Queens-Rocket-Engineering-Team/ctl-panda/README.md

# PANDA Control Board

PANDA (Propulsion Actuation and Nominal Data Acquisition) is the control PCB for the Queen's Rocket Engineering Team's
hybrid rocket engine. During launch, PANDA controls systems on the fill plumbing panel, controls rocket ignition, and
provides pre-launch data acquisition. PANDA also functions as a standalone static fire test stand controller that
can execute all aspects of a hot-fire test.

## Assembled PCB

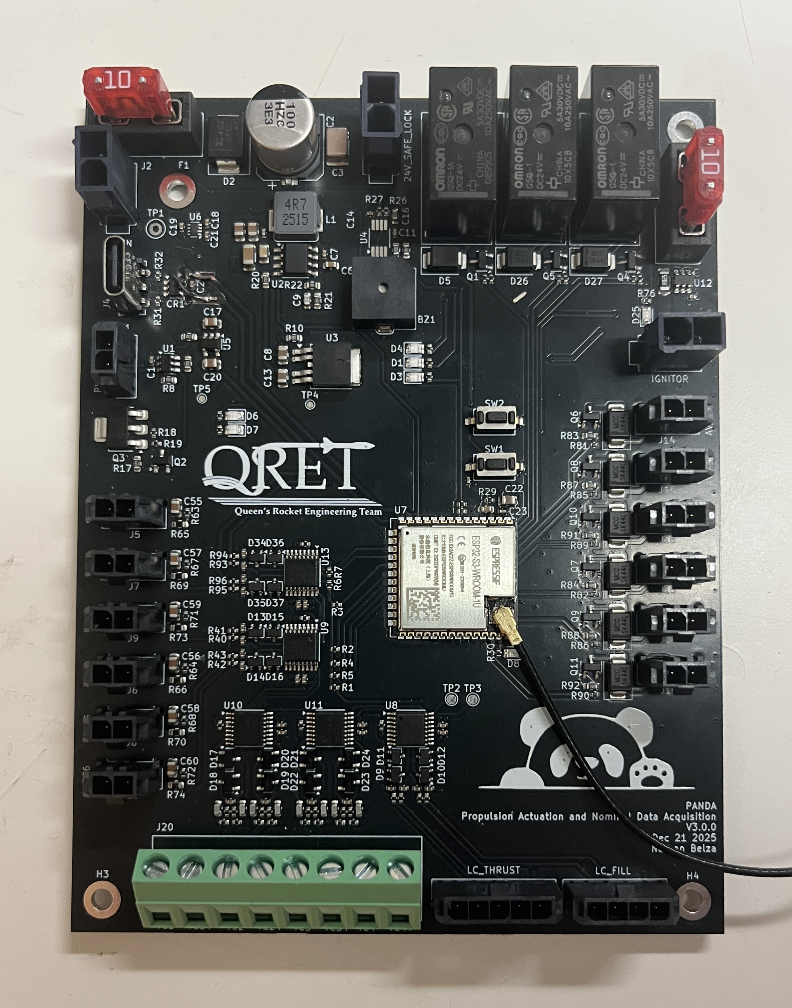
[picture p1: media/assembled_board.jpg]
Assembled PANDA PCB


## System Architecture

PANDA uses an ESP32S3-WROOM-1U microcontroller for systems control. This ESP32S3 communicates with an external control
server to for remote control and data streaming over 2.4GHz WiFi. All commands are sent from the external server, as
PANDA does not autonomously control any systems.

Five ADS112C04 ADCs provide sensor readings to the ESP32S3 over an I2C bus. Sensors supported are:

- 6 pressure transducers
- 4 thermocouples
- 2 load cells

PANDA is also capable of monitoring ignitor characteristics. Measurements of the current passing through a nichrome wire
ignitor are obtained using a current sense amplifier across a shunt resistor in the ignitor path. Ignitor resistance
readings are also measured by injecting a small current from an IDAC on an ADC, and
measuring the resulting voltage.

A communications diagram for PANDA can be seen below.

```mermaid
---
title: PANDA Communications Flow
---
flowchart LR

    ADC(ADS112C04<br>ADCs) <==I2C==> ESP(ESP32 MCU)

    subgraph Controls
        AV(Actuated Valves)
        24VSAFE[24VSAFE<br>Relay]
        RUN[Ignitor Run<br>Relay]
        PRIME[Ignitor Prime<br>Relay]
    end

    subgraph Sensors
        PT(Pressure Transducers)
        TC(Thermocouples)
        LC(Load Cells)
        CUR(Ignitor Current)
        RES(Ignitor Resistance)
    end

    PT --> ADC
    TC --> ADC
    LC --> ADC
    CUR --> ADC
    RES --> ADC

    ESP --> AV
    ESP -->24VSAFE
    ESP --> RUN
    ESP --> PRIME

    ESP <-. WiFI .-> WIFI(External Server)
```

## Power Architecture

PANDA operates from a 24VDC power supply, and has a maximum current rating of 10A. The 24V rail is first stepped down to 5.3V with a switching converter and then dropped to 5V and 3.3V with LDOs. The 5V rail supplies analog systems, and the 3.3V rail supplies digital systems. Using LDOs on the switching output allows for low-noise power for analog measurements.

The 24VSAFE rail is only be energized when the fill panel is vacated, as it powers hazardous components such as the ignitor. The ignitor utilizes two relays in series for additional redundancy, and to ensure ignition is always intentional. A power distribution chart of PANDA can be seen below. This graph does not include the power sequencing and filtering present on the board.

```mermaid
---
title: PANDA Power Distribution
---
flowchart LR

    24VIN([24VIN]) --> 24VSAFE[24VSAFE<br>Relay]

    subgraph Valves
        AV(Valves)
        AVSAFE(Fill Valve<br>Run Valve)
    end
    24VIN --> AV
    24VSAFE --> AVSAFE

    subgraph Ignitor
        RUN[Ignitor Run<br>Relay]
        RUN --> PRIME[Ignitor Prime<br>Relay]
        PRIME --> IGN(Ignitor)
    end

    24VSAFE --> RUN[Ignitor Run<br>Relay]

    subgraph Voltage Regulation
        BUCK([5.3V Buck])
        BUCK --> 5V([5V LDO])
        BUCK --> 3V3([3.3V LDO])
    end

    24VIN --> BUCK([5.3V Buck])

    subgraph Sensors
        PT(Pressure Transducers)
        LC(Load Cells)
        RES(Ignitor Current<br>Sensor)
    end

    5V --> ADC(ADS112C04<br>ADCs)
    3V3 --> ESP(ESP32 MCU)
    3V3 --> ADC
    24VIN --> PT
    5V --> LC
    5V --> RES
```

## Required Software

This project was created using KiCad v10.0. If manufacturing with JLCPCB, install the Fabrication Toolkit KiCad plugin for JLCPCB.

## Recommended Manufacturing Options

If ordering from JLCPCB, use the JLC04161H-3313 stackup option. For JLC PCBA, the standard PCBA option is required due
to the ESP32S3-WROOM-1U being unavailable as a part in the economic PCBA assembly.
