Queens-Rocket-Engineering-Team/ctl-panda/panda.kicad_sch

## KiCad design panda.kicad_sch (2026-09-28)

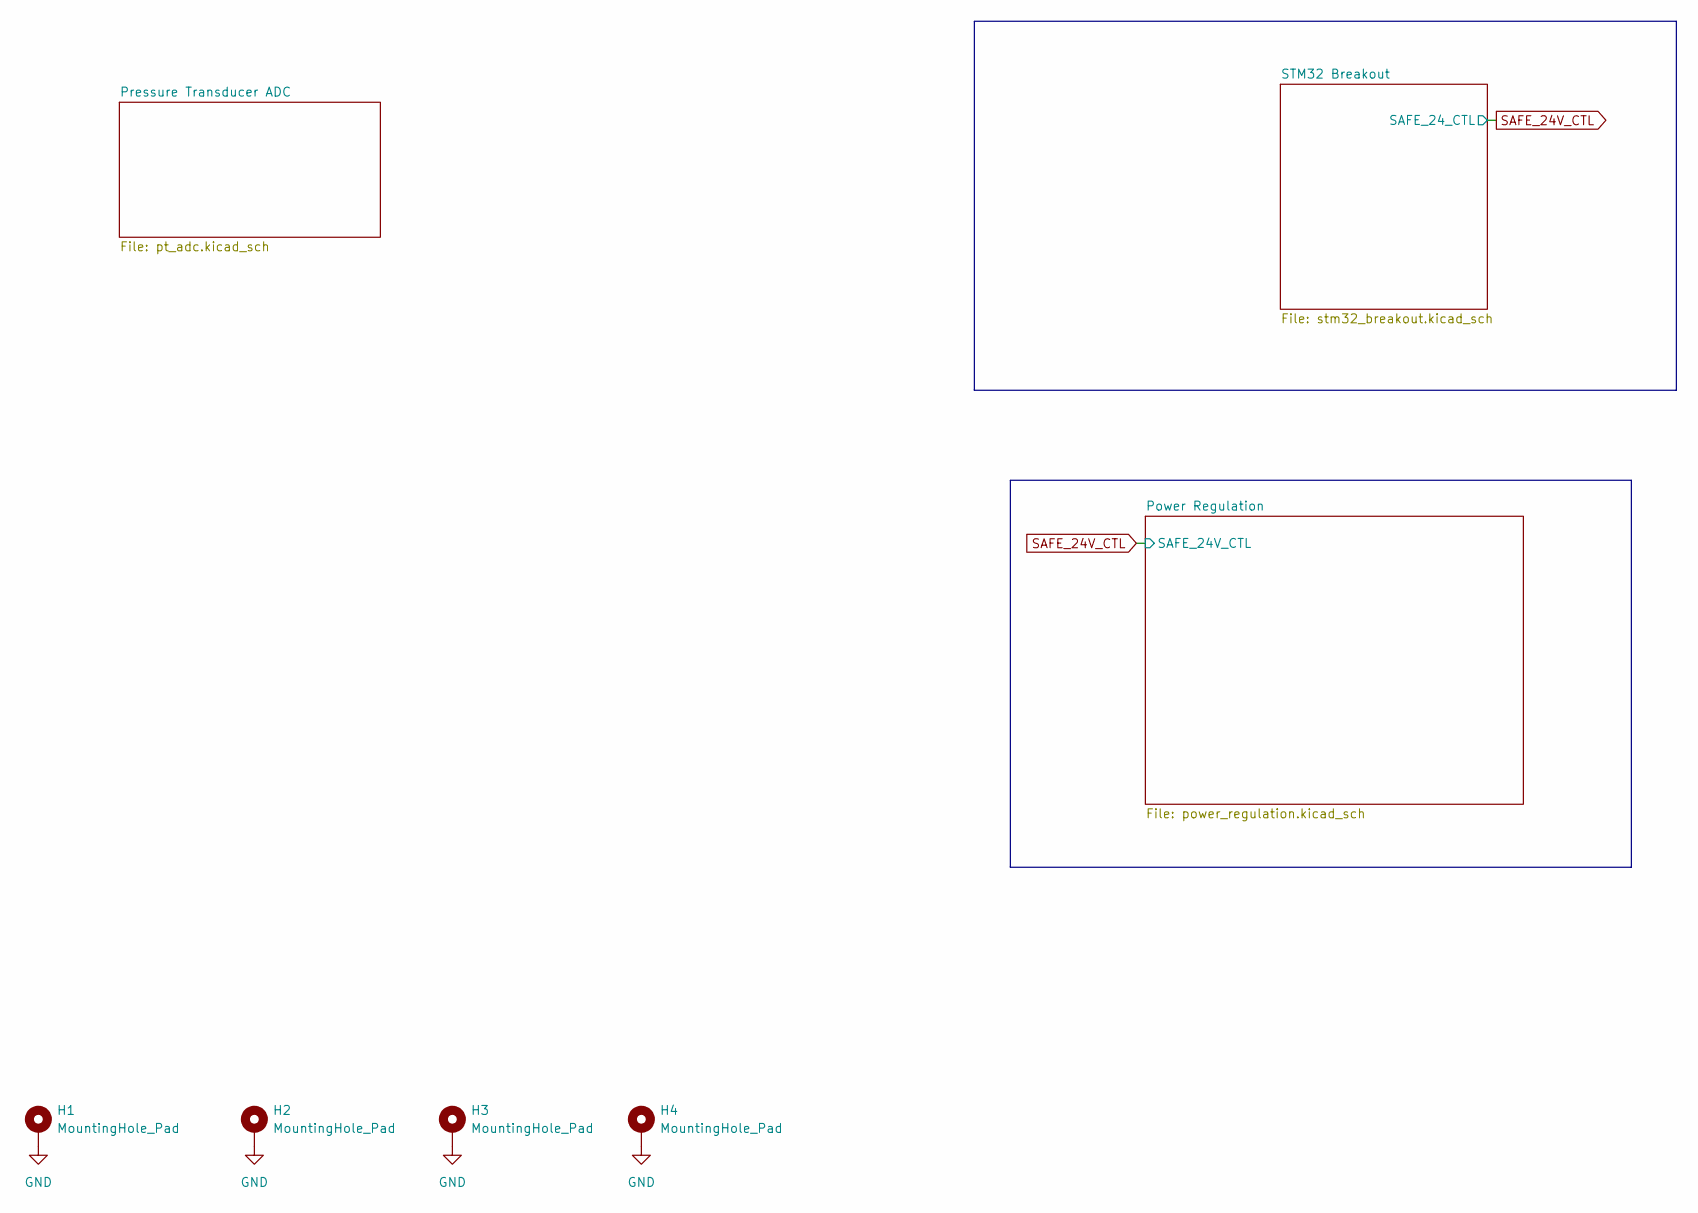
[picture p2: schematic panda.kicad_sch]

Parts:
H1, H2, H3, H4: MountingHole_Pad; MountingHole_3.2mm_M3_ISO7380_Pad

Connections:
GND: H1.1, H2.1, H3.1, H4.1
