Queens-Rocket-Engineering-Team/ctl-panda/power_regulation.kicad_sch

## KiCad design power_regulation.kicad_sch (2026-09-28)

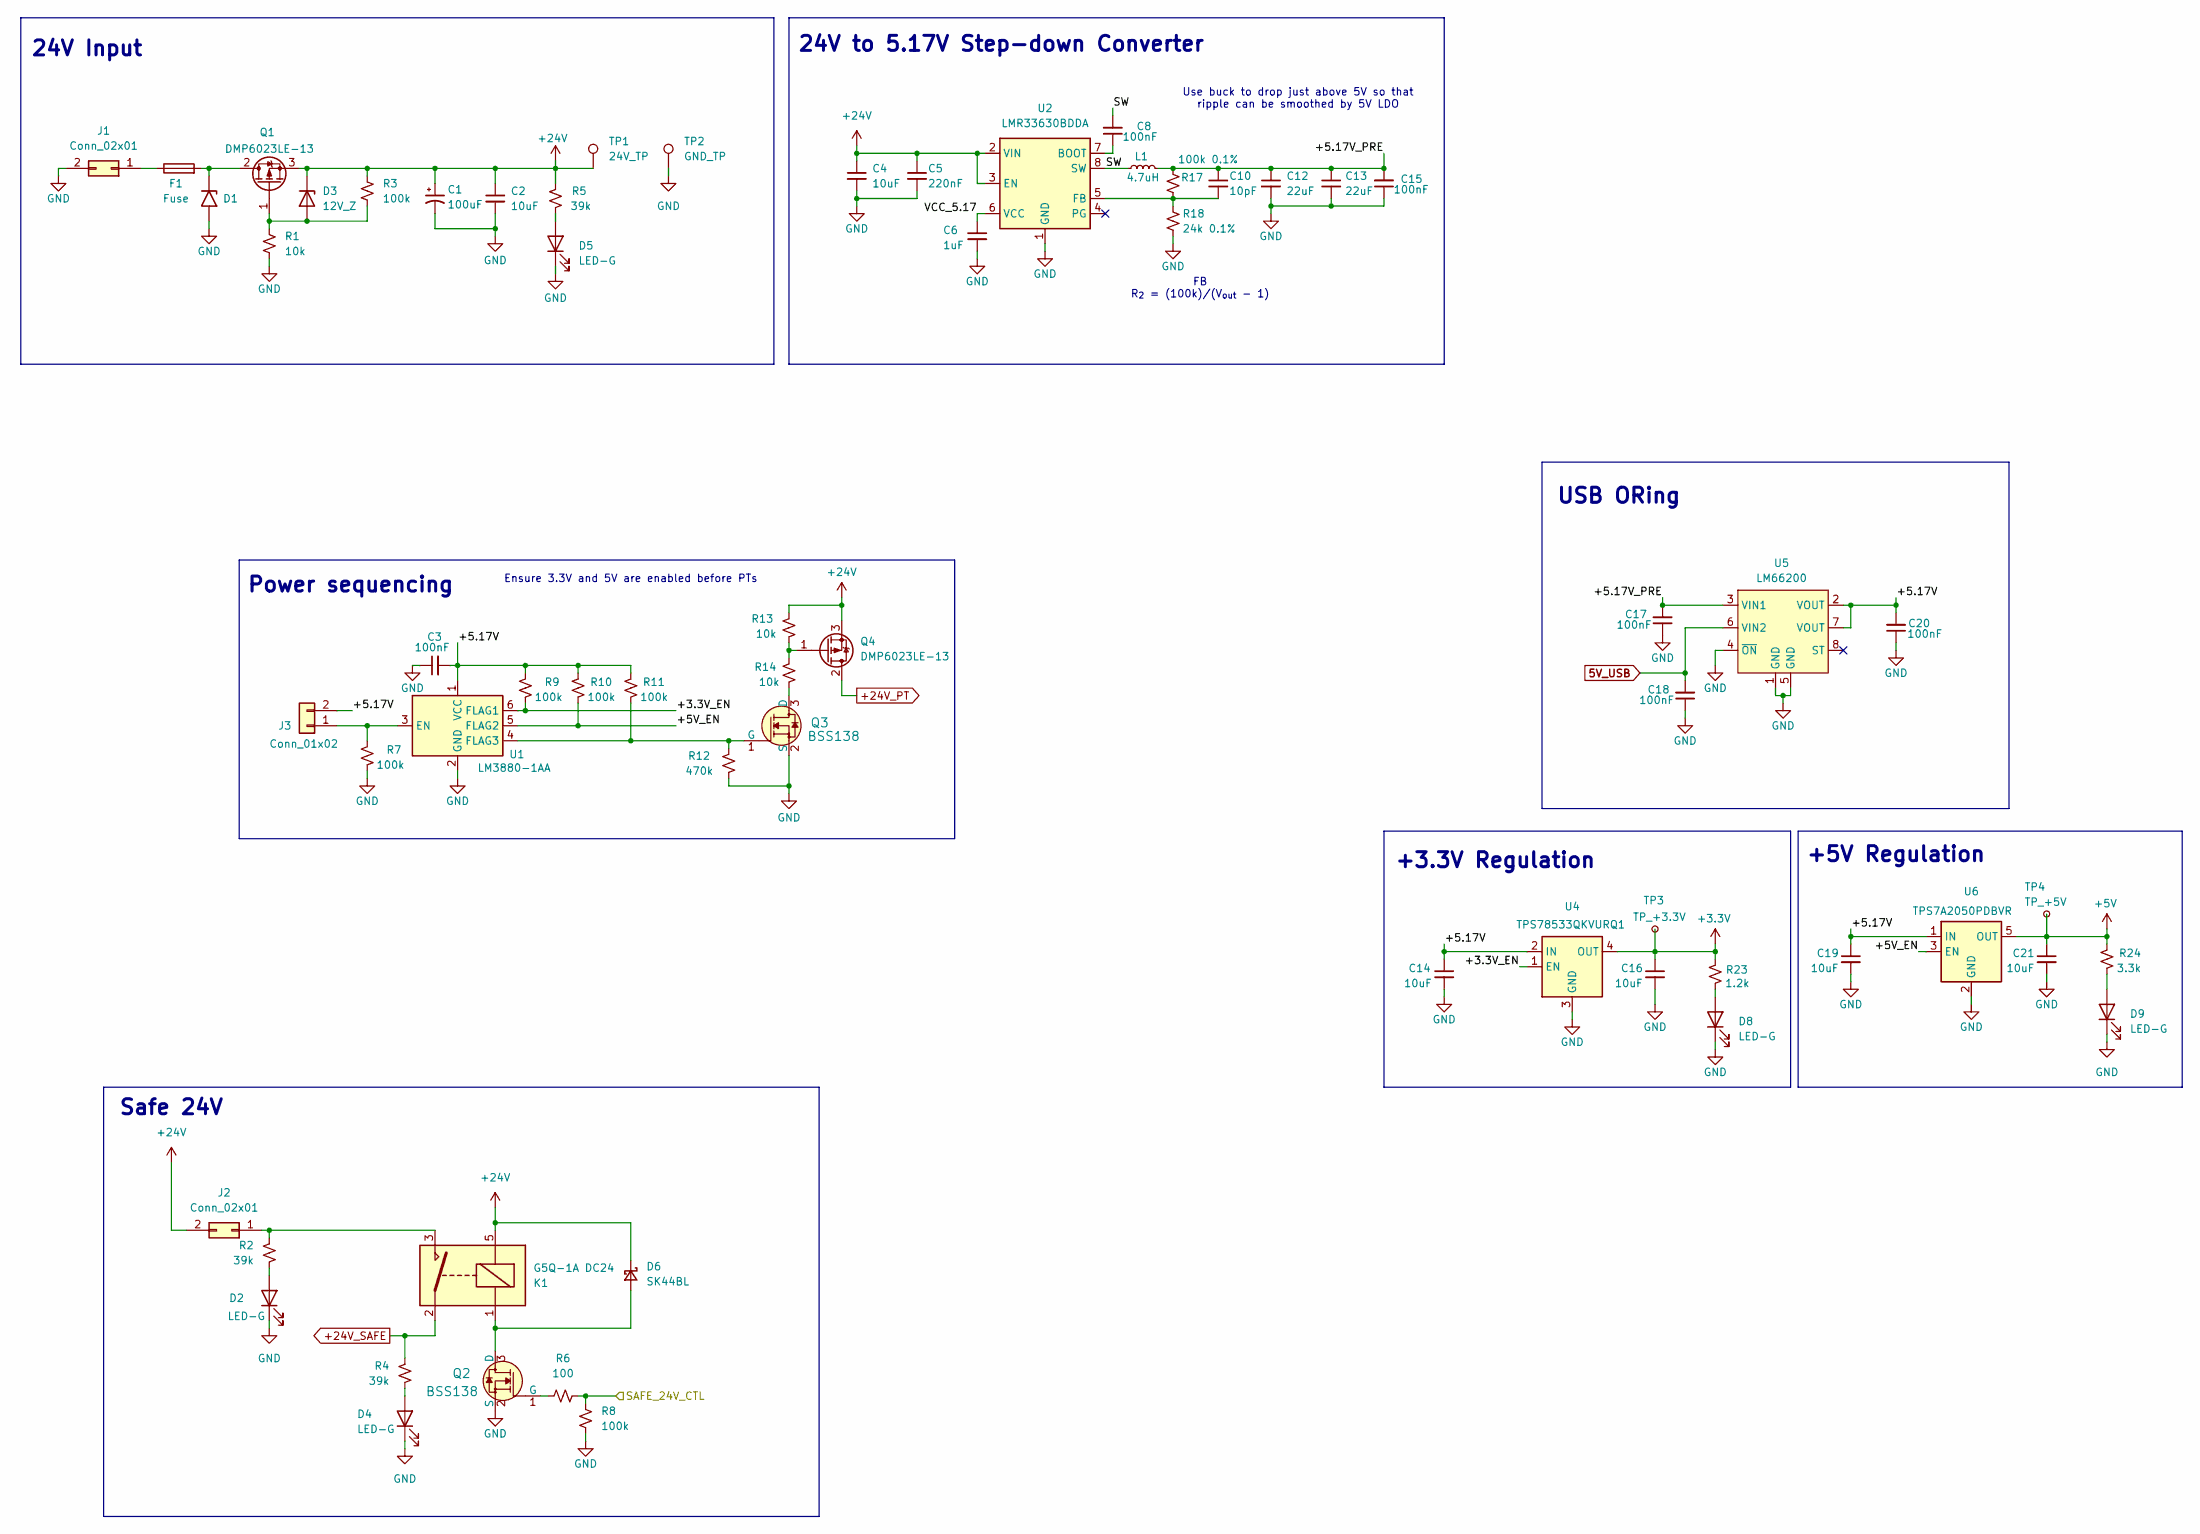
[picture p3: schematic power_regulation.kicad_sch]

Parts:
C1: 100uF; CP_Radial_D8.0mm_P5.00mm; MPN EEU-FR1H101B
C2, C14, C16, C19, C21: 10uF
C3, C17, C18, C20: 100nF
C4: 10uF; C_1206_3216Metric; LCSC C13585
C5: 220nF; C_0805_2012Metric; LCSC C5378
C6: 1uF; C_0603_1608Metric; LCSC C15849
C8, C15: 100nF; C_0402_1005Metric; LCSC C307331
C10: 10pF; C_0603_1608Metric; LCSC C1634
C12, C13: 22uF; C_0805_2012Metric; LCSC C45783
D1: SMCJ26A-13-F; D_SMC; LCSC C135156
D2, D4, D5, D8, D9: LED-G; LED_0805_2012Metric; LCSC C2297
D3: 12V_Z; D_SOD-123; LCSC C500776
D6: SK44BL; D_SMB; MPN SK44BL-TP; LCSC C151740
F1: Fuse; Fuseholder_Blade_Mini_Keystone_3568; LCSC N/A
J1: Conn_02x01; Molex_Mini-Fit_Jr_5566-02A_2x01_P4.20mm_Vertical; LCSC N/A
J2: Conn_02x01; Molex_Mini-Fit_Jr_5566-02A_2x01_P4.20mm_Vertical
J3: Conn_01x02; Molex_Micro-Fit_3.0_43650-0215_1x02_P3.00mm_Vertical
K1: G5Q-1A DC24; Relay_SPST_Omron-G5Q-1A
L1: 4.7uH; L_Bourns_SRP7028A_7.3x6.6mm; LCSC C840529
Q1, Q4: DMP6023LE-13; SOT-223-3_TabPin2; LCSC C154901
Q2, Q3: BSS138; SOT-23-3; MPN BSS138; LCSC C8490
R1, R13, R14: 10k
R2, R4, R5: 39k
R3, R7, R8, R9, R10, R11: 100k
R6: 100
R12: 470k
R17: 100k 0.1%; R_0603_1608Metric; LCSC C122538
R18: 24k 0.1%; R_0603_1608Metric; LCSC C326729
R23: 1.2k
R24: 3.3k
TP1: 24V_TP; TestPoint_Loop_D2.50mm_Drill1.0mm; LCSC N/A
TP2: GND_TP; TestPoint_Loop_D2.50mm_Drill1.0mm; LCSC N/A
TP3: TP_+3.3V; TestPoint_Pad_D1.0mm; LCSC N/A
TP4: TP_+5V; TestPoint_Pad_D1.0mm; LCSC N/A
U1: LM3880-1AA; SOT-23-6; LCSC C486059
U2: LMR33630BDDA; Texas_HSOP-8-1EP_3.9x4.9mm_P1.27mm_ThermalVias; LCSC C544370
U4: TPS78533QKVURQ1; TO-252-4; LCSC C3748131
U5: LM66200; SOT-583-8; LCSC C3235556
U6: TPS7A2050PDBVR; SOT-23-5; LCSC C2864504

Connections:
5V_USB: C18.2, U5.6 (VIN2)
+3.3V: C16.1, R23.2, TP3.1, U4.4 (OUT)
+3.3V_EN: R9.1, U1.6 (FLAG1), U4.1 (EN)
+5.17V: C3.2, C14.1, C19.1, C20.2, J3.2, R9.2, R10.2, R11.2, U1.1 (VCC), U4.2 (IN), U5.2 (VOUT), U5.7 (VOUT), U6.1 (IN)
+5.17V_PRE: C10.1, C12.1, C13.1, C15.2, C17.2, L1.2, R17.1, U5.3 (VIN1)
+5V: C21.1, R24.2, TP4.1, U6.5 (OUT)
+5V_EN: R10.1, U1.5 (FLAG2), U6.3 (EN)
+24V: C1.1, C2.1, C4.1, C5.1, D3.1 (K), D6.1 (K), J2.2, K1.5, Q1.3 (S), Q4.3 (S), R3.1, R5.2, R13.2, TP1.1, U2.2 (VIN), U2.3 (EN)
+24V_PT: Q4.2 (D)
+24V_SAFE: K1.2, R4.2
GND: C1.2, C2.2, C3.1, C4.2, C5.2, C6.2, C12.2, C13.2, C14.2, C15.1, C16.2, C17.1, C18.1, C19.2, C20.1, C21.2, D1.2 (A2), D2.1 (K), D4.1 (K), D5.1 (K), D8.1 (K), D9.1 (K), J1.2, Q2.2 (S), Q3.2 (S), R1.2, R7.1, R8.2, R12.1, R18.2, TP2.1, U1.2 (GND), U2.1 (GND), U2.9 (GND), U4.3 (GND), U5.1 (GND), U5.4 (~ON), U5.5 (GND), U6.2 (GND)
unnamed: C8.1, U2.7 (BOOT)
unnamed: C10.2, R17.2, R18.1, U2.5 (FB)
unnamed: D1.1 (A1), F1.2, Q1.2 (D)
unnamed: D2.2 (A), R2.1
unnamed: D3.2 (A), Q1.1 (G), R1.1, R3.2
unnamed: D4.2 (A), R4.1
unnamed: D5.2 (A), R5.1
unnamed: D6.2 (A), K1.1, Q2.3 (D)
unnamed: D8.2 (A), R23.1
unnamed: D9.2 (A), R24.1
unnamed: F1.1, J1.1
unnamed: J2.1, K1.3, R2.2
unnamed: J3.1, R7.2, U1.3 (EN)
unnamed: Q2.1 (G), R6.1
unnamed: Q3.1 (G), R11.1, R12.2, U1.4 (FLAG3)
unnamed: Q3.3 (D), R14.1
unnamed: Q4.1 (G), R13.1, R14.2
SAFE_24V_CTL: R6.2, R8.1
SW: C8.2, L1.1, U2.8 (SW)
VCC_5.17: C6.1, U2.6 (VCC)

Notes on the sheet:
24V Input
Ensure 3.3V and 5V are enabled before PTs
24V to 5.17V Step-down Converter
USB ORing
Use buck to drop just above 5V so that ripple can be smoothed by 5V LDO
FB R_{2} = (100k)/(V_{out} - 1)
+5V Regulation
+3.3V Regulation
Power sequencing
Safe 24V
