Queens-Rocket-Engineering-Team/ctl-panda/pt_adc.kicad_sch

## KiCad design pt_adc.kicad_sch (2026-09-28)

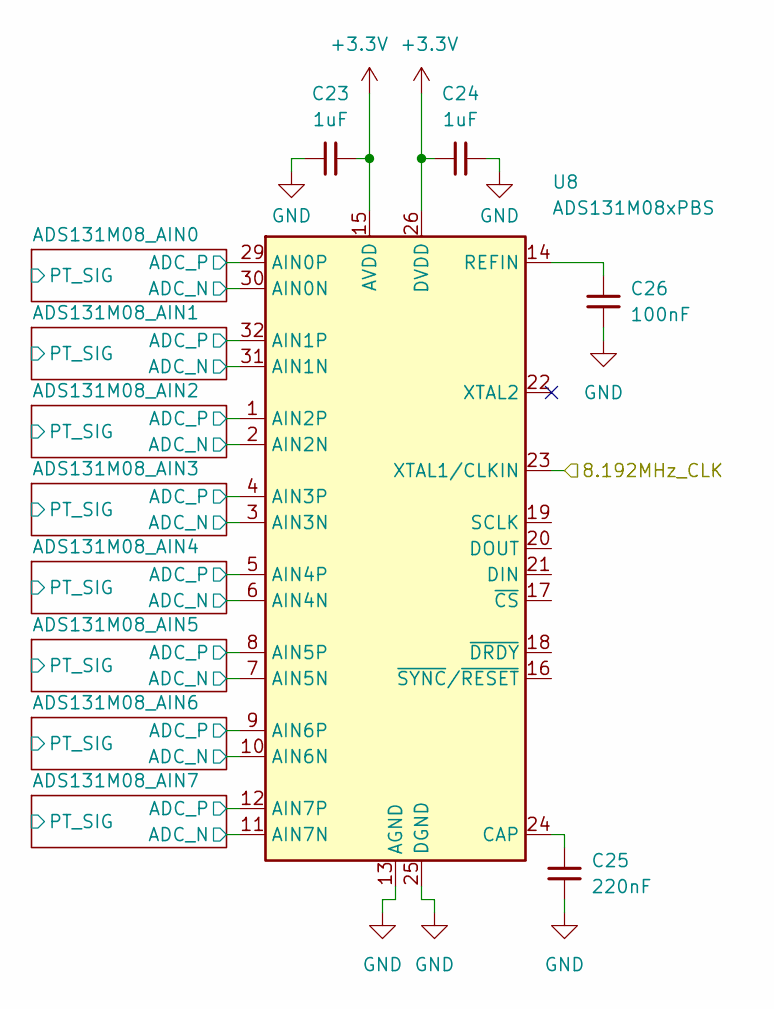
[picture p4: schematic pt_adc.kicad_sch]

Parts:
C23, C24: 1uF; C_0603_1608Metric
C25: 220nF; C_0603_1608Metric
C26: 100nF; C_0603_1608Metric
U8: ADS131M08xPBS; TQFP-32_5x5mm_P0.5mm

Connections:
8.192MHz_CLK: U8.23 (XTAL1/CLKIN)
+3.3V: C23.2, C24.1, U8.15 (AVDD), U8.26 (DVDD)
ADC_N: U8.2 (AIN2N), U8.3 (AIN3N), U8.6 (AIN4N), U8.7 (AIN5N), U8.10 (AIN6N), U8.11 (AIN7N), U8.30 (AIN0N), U8.31 (AIN1N)
ADC_P: U8.1 (AIN2P), U8.4 (AIN3P), U8.5 (AIN4P), U8.8 (AIN5P), U8.9 (AIN6P), U8.12 (AIN7P), U8.29 (AIN0P), U8.32 (AIN1P)
GND: C23.1, C24.2, C25.2, C26.2, U8.13 (AGND), U8.25 (DGND), U8.27 (AGND), U8.28 (AGND)
unnamed: C25.1, U8.24 (CAP)
unnamed: C26.1, U8.14 (REFIN)
