Queens-Rocket-Engineering-Team/ctl-panda/pt_frontend.kicad_sch

## KiCad design pt_frontend.kicad_sch (2026-09-28)

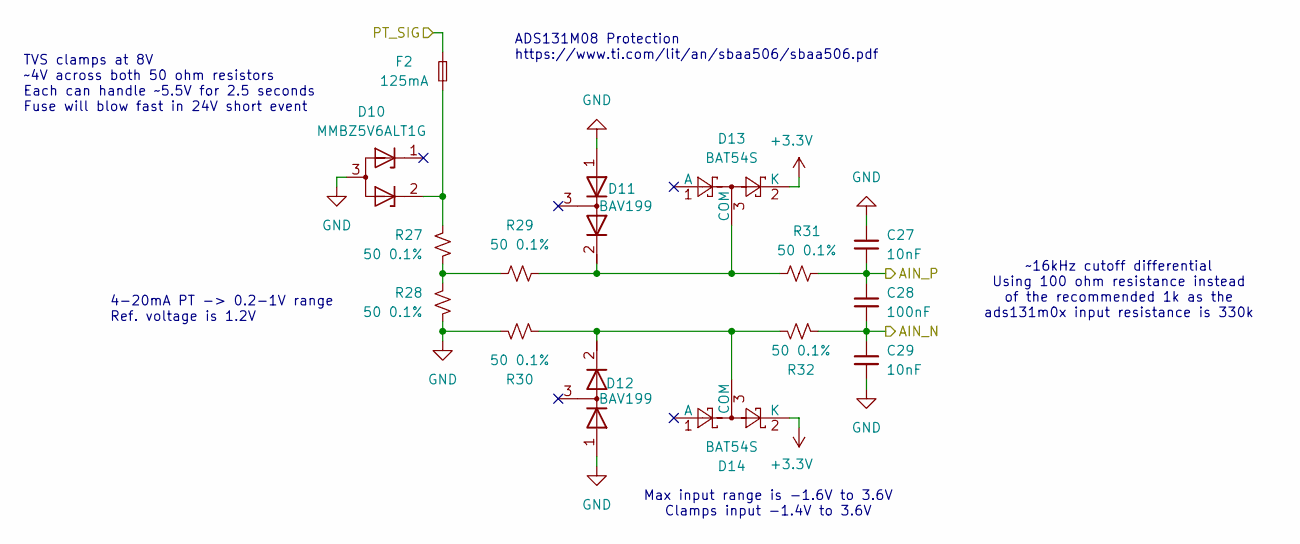
[picture p5: schematic pt_frontend.kicad_sch]

Parts:
C27, C29: 10nF; C_0603_1608Metric; LCSC C85973
C28: 100nF; C_1206_3216Metric; LCSC C97946
D10: MMBZ5V6ALT1G; SOT-23; LCSC C123251
D11, D12: BAV199; SOT-23
D13, D14: BAT54S; SOT-23
F2: 125mA; Fuse_1206_3216Metric; LCSC C206983
R27, R28, R29, R30, R31, R32: 50 0.1%; R_0603_1608Metric; LCSC C849792

Connections:
+3.3V: D13.2 (K), D14.2 (K)
AIN_N: C28.2, C29.1, R32.2
AIN_P: C27.2, C28.1, R31.2
GND: C27.1, C29.2, D10.3 (A), D11.1 (A), D12.1 (A), R28.1, R30.1
unnamed: D10.2 (K), F2.2, R27.2
unnamed: D11.2 (K), D13.3 (COM), R29.2, R31.1
unnamed: D12.2 (K), D14.3 (COM), R30.2, R32.1
unnamed: R27.1, R28.2, R29.1
PT_SIG: F2.1

Notes on the sheet:
~16kHz cutoff differential Using 100 ohm resistance instead of the recommended 1k as the ads131m0x input resistance is 330k
ADS131M08 Protection https://www.ti.com/lit/an/sbaa506/sbaa506.pdf
TVS clamps at 8V ~4V across both 50 ohm resistors Each can handle ~5.5V for 2.5 seconds Fuse will blow fast in 24V short event
4-20mA PT -> 0.2-1V range Ref. voltage is 1.2V
Max input range is -1.6V to 3.6V Clamps input -1.4V to 3.6V
