Queens-Rocket-Engineering-Team/ctl-panda/stm32_breakout.kicad_sch

## KiCad design stm32_breakout.kicad_sch (2026-10-09, an earlier design)

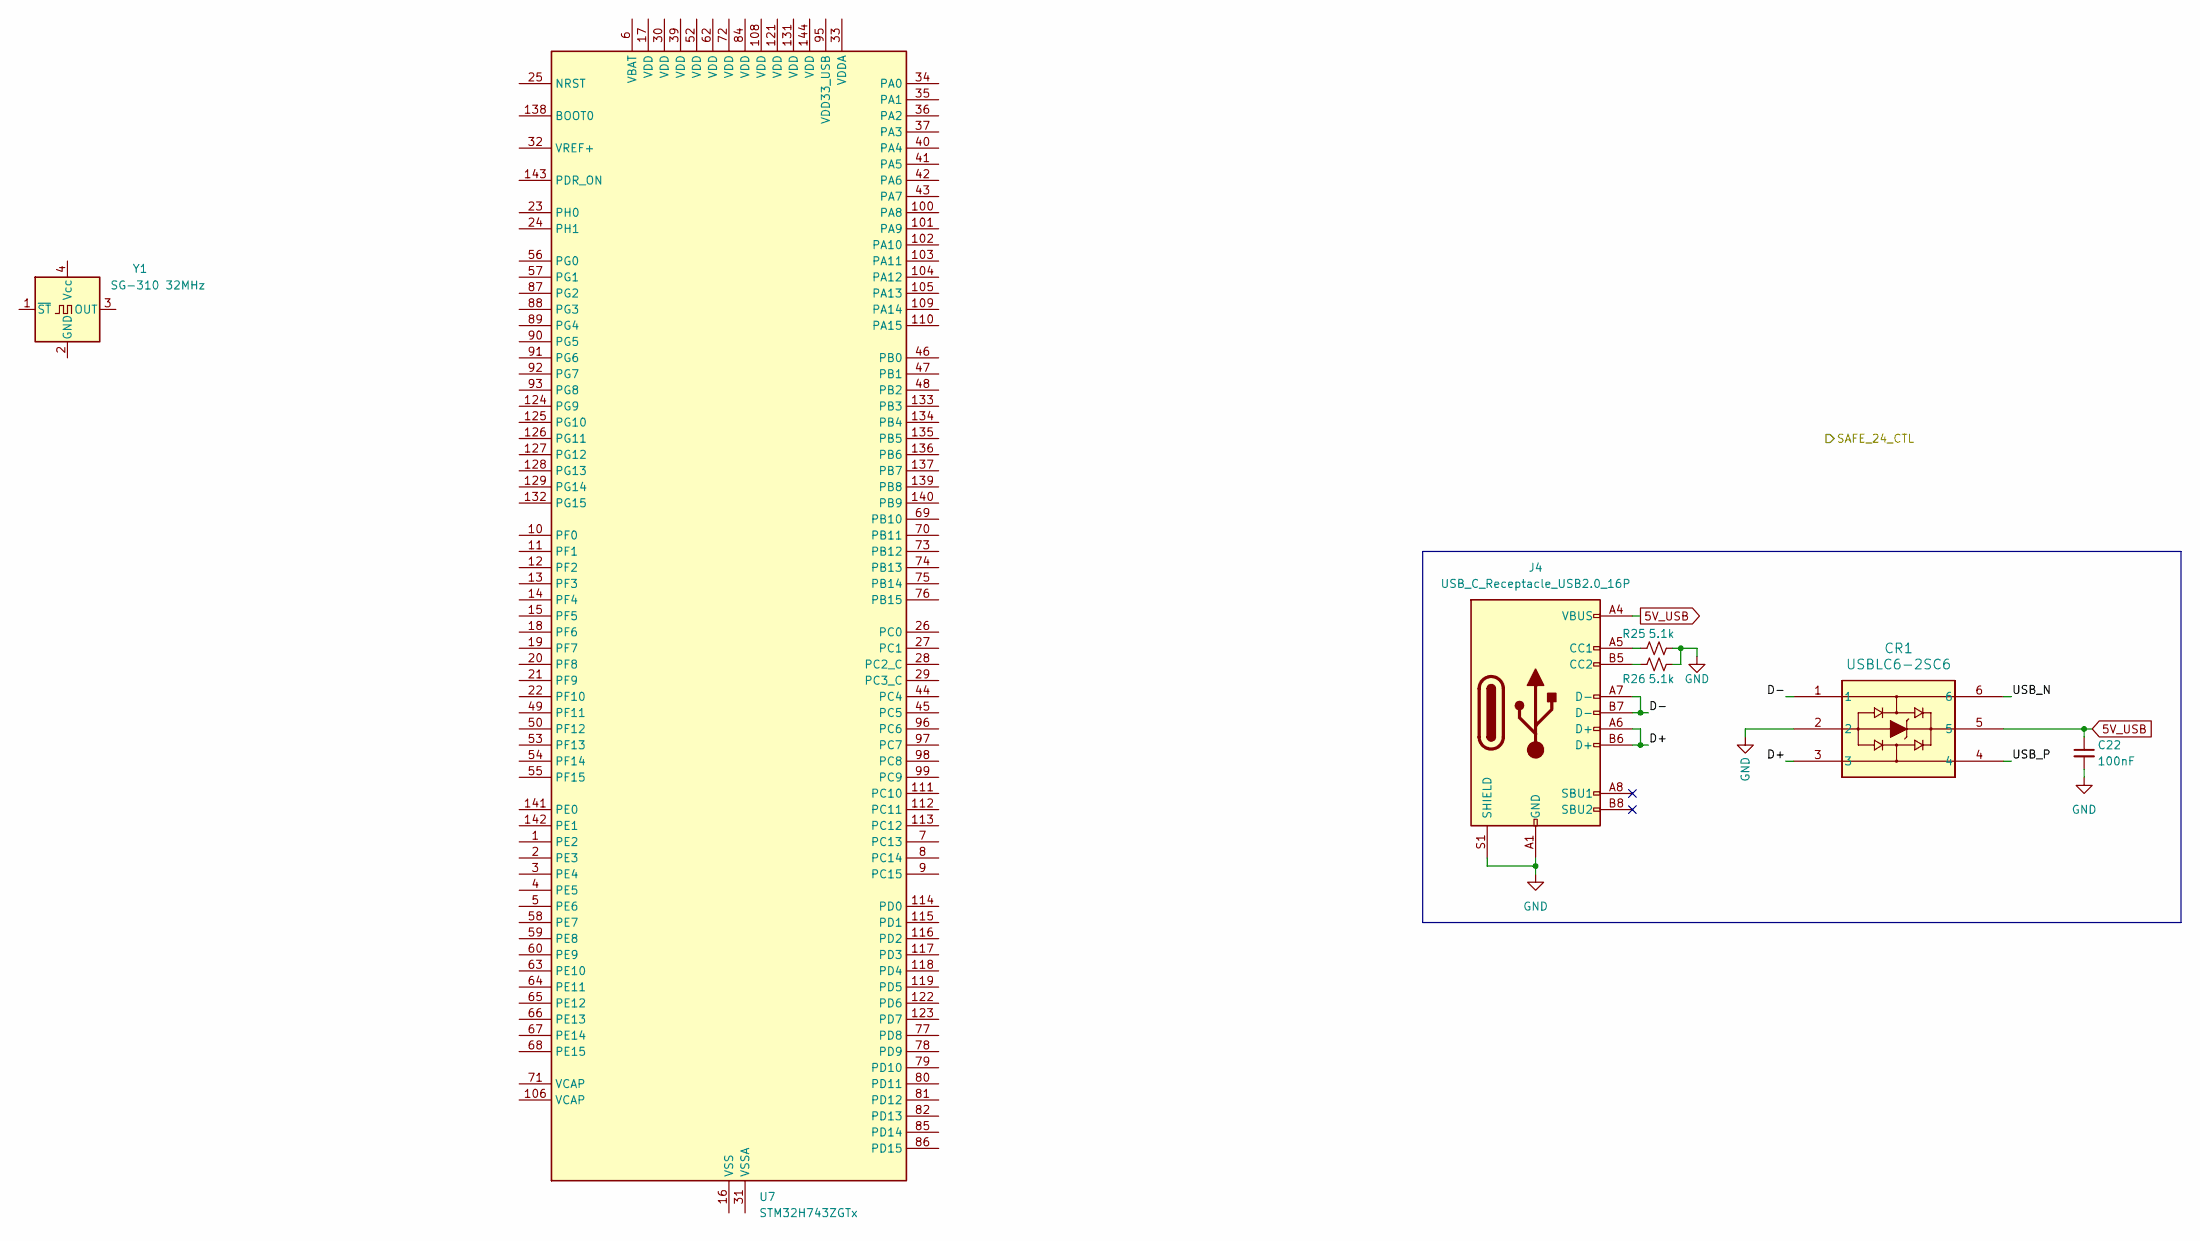
[picture p6: schematic stm32_breakout.kicad_sch]

Parts:
C22: 100nF
CR1: USBLC6-2SC6; SOT-23-6; LCSC C7519
J4: USB_C_Receptacle_USB2.0_16P; USB_C_Receptacle_G-Switch_GT-USB-7051x; LCSC C2843970
R25, R26: 5.1k
U7: STM32H743ZGTx; LQFP-144_20x20mm_P0.5mm
Y1: SG-310 32MHz; Crystal_SMD_3225-4Pin_3.2x2.5mm; LCSC C915094

Connections:
5V_USB: C22.1, CR1.5, J4.A4 (VBUS), J4.A9 (VBUS), J4.B4 (VBUS), J4.B9 (VBUS)
D+: CR1.3, J4.A6 (D+), J4.B6 (D+)
D-: CR1.1, J4.A7 (D-), J4.B7 (D-)
GND: C22.2, CR1.2, J4.A1 (GND), J4.A12 (GND), J4.B1 (GND), J4.B12 (GND), J4.S1 (SHIELD), R25.2, R26.2
unnamed: J4.A5 (CC1), R25.1
unnamed: J4.B5 (CC2), R26.1
unnamed: U7.16 (VSS), U7.38 (VSS), U7.51 (VSS), U7.61 (VSS), U7.83 (VSS), U7.94 (VSS), U7.107 (VSS), U7.120 (VSS), U7.130 (VSS)
USB_N: CR1.6
USB_P: CR1.4
