Queens-Rocket-Engineering-Team/ctl-panda/(commit log)

2026-09-20 clean up repo
    [ESP32Breakout.kicad_sch, PowerRegulation.kicad_sch, SignalConditioning.kicad_sch, adc_circuitry.kicad_sch, esp32_breakout.kicad_sch, ignitor_adc.kicad_sch, ignitor_control.kicad_sch, load_cell_measurement.kicad_sch]
2026-09-26 remove remainder of leftofer schematics
    [adc_circuitry.kicad_sch, esp32_breakout.kicad_sch, ignitor_adc.kicad_sch, ignitor_control.kicad_sch, load_cell_measurement.kicad_sch, panda.kicad_sch, power_regulation.kicad_sch, pressure_transducer_measurement.kicad_sch]
2026-09-28 add afe for pressure transducers
    [esp32_breakout.kicad_sch, panda.kicad_pcb, panda.kicad_sch, power_regulation.kicad_sch, pt_adc.kicad_sch, pt_frontend.kicad_sch, stm32_breakout.kicad_sch]
